Fred-Guo0422/Adapter-Functional-test-fixture/images/img2.jpg

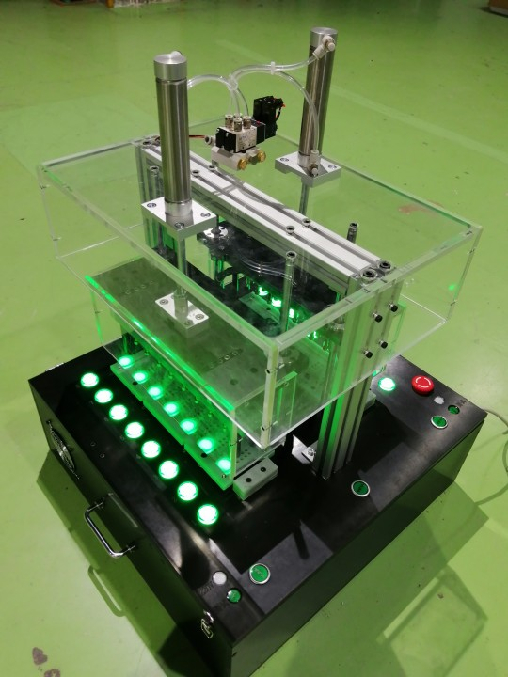
images/img2.jpg
