Fred-Guo0422/Adapter-Functional-test-fixture/images/img1.png

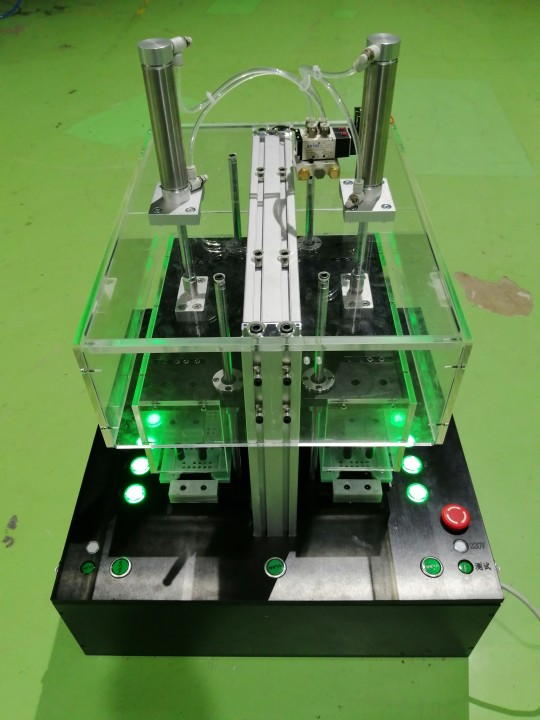
images/img1.png
