Fred-Guo0422/Adapter-Functional-test-fixture/README.md

#  Kambo Basic功能测试夹具

#### 介绍
赛尔康Kambo Basic功能测试夹具
输入图片说明

#### 软件架构
软件架构说明

#### 安装教程

#### 使用说明

#### 参与贡献

1.  Fork 本仓库
2.  新建 Feat_xxx 分支
3.  提交代码
4.  新建 Pull Request

#### 特技
