Fred-Guo0422/Adapter-Functional-test-fixture/TAE-22001JC Kambo Basic功能测试夹具 PO单9700009738.pdf

Payment terms | AMS 30 days | Currency RMB
Delivery terms | DDP Guigang

Mode of transport
We'd ask you to send the order confirmation within two working days
from the order date. PLS NOTE: Delivery time at destination. _______________________________________________________________________
Item | Our code | Your code | Storage Location
| Description
Delivery Date | Quantity Unit | Price _______________________________________________________________________

00010
Kambo Basic功能测试夹具 | Req.No: FR21121101
PR No./Item: 85781705/00010 | Requestor: Leon Gan
31.12.2021 | 1 SET | 13,570.00/1
13,570.00
Order 9M210034
_______________________________________________________________________ Tot. net item val. excl. tax RMB 13,570.00

苏州领略智能科技有限公司
苏州市相城区黄埭镇太东路2988号
苏州
Telefax:

Delivery address
Salcomp (Guigang) Co., Ltd.
China
Xijiang Industrial Park, Gangbei Di Guigang 537104

Delivery date Day 31.12.2021

_______________________________________________________________________

Company Name | Address | Telephone No. | Fax No.. | Bank account:
Salcomp | Salcomp Road, Xijiang industrial park | ,+86(755) 27255 111 | +86(755)27255 255 | Shenzhen PingAn Bank,
(Guigang) Co., Ltd. | Gangbei district, Guigang City | | +86(755)27255 677 | Shajing Branch
| Guangxi province - 537104, China | | | Swift Code: Guigang

____________________________________________________________________ MRO PO(GG)

PO number/date
9700009738 / 20.12.2021
Contact person/Telephone
HLI-Henry LI/755-27255111
Our fax number
+86-755-27255 255

Your vendor number with us
900170

_______________________________________________________________________

Item | Our code | Your code | Storage Location
| Description
Delivery Date | Quantity Unit | Price _______________________________________________________________________
Approved by | Made by
Tracy Hu | Henry LI
20.12.2021
_______________ | _______________

苏州领略智能科技有限公司
苏州市相城区黄埭镇太东路2988号
苏州

Environment Requirement: All the materials delivered to Salcomp should be compliance to the latest version requirement of <GWI 4-11 Salcomp Hazardous Substances Management Standard> _______________________________________________________________________

Company Name | Address | Telephone No. | Fax No.. | Bank account:
Salcomp | Salcomp Road, Xijiang industrial park | ,+86(755) 27255 111 | +86(755)27255 255 | Shenzhen PingAn Bank,
(Guigang) Co., Ltd. | Gangbei district, Guigang City | | +86(755)27255 677 | Shajing Branch
| Guangxi province - 537104, China | | | Swift Code: Guigang

____________________________________________________________________

PO number/date
9700009738 / 20.12.2021

Page
2 ( 2)
