Fred-Guo0422/Adapter-Functional-test-fixture/发包清单/TAE-22001JC Kambo Basic功能测试夹具发包明细1221V1.0.xls

Sheet: 发包申请单
 | 2021-12-21
苏州领略智能发包申请单
案名: | Kambo Basic功能测试夹具 |  |  |  | 案号: | TAE-22001JC |  |  | 本案第( 1 )次发包
序号 | 名称/规格 |  | 数量 | 预估金额 | 请购日期 | 需求日期 | 设计者 | 应用单位 | 建议厂商及备注事项
1 | 机构标准件明细表 |  | 1頁 |  | 2021-12-21 | 2021-12-29 | 曾凡超 | 贵港赛尔康
2 | 机构加工件明细表 |  | 1頁 |  | 2021-12-21 | 2021-12-29 | 曾凡超 | 贵港赛尔康
3 | 测试标准件明细表 |  | 1頁 |  | 2021-12-21 | 2021-12-29 | 李游 | 贵港赛尔康
4 | 以下空白
本次发包预算小计(RMB)元
预算管控 |  | 备品领用花费(RMB)元 |  |  | 预领备品确认 |  |  | 本次发包采购预算(RMB)元
执行单材料费： |  | 累计发包预算金额： |  |  |  |  | 剩余预算金额：
 |  | 累计实际预算金额： |  |  |  |  | 实际剩余金额：
备注 | 1﹑发包申请由设计者负责填写，要写清楚案名、案号、图号，发包前设计者在备品室确认预领备品，仓管员填写领用费用及签字后，交项目课长。
 | 2﹑本次发包预算小计及采购预算由项目课长依照备品领用费用核算后填写。
 | 3﹑发包申请由项目课长及总监审核后，核准生效。
 | 4﹑核准生效后，发包单同图纸及明细一并送工程管理处存档。
 | □ 新发包 | □ 客户设变 |  | □ 设计设变 |  | □ 其他设变 / |  | □ 加工件 | □ 标准件
核准﹕ |  |  | 企划： |  |  | 审核﹕ |  |  | 申请﹕

Sheet: 机构标准件明细表
苏州领略智能
标准件明细表
案 名 |  |  | Kambo Basic功能测试夹具 |  | 案 号 |  | TAE-22001JC
工 序 |  |  |  |  | 图 号 |  | TAE-22001JC
使用厂区及部门 |  |  |  |  | 产品名称
序号 | 物料编号 | 名 称 | 型 号 / 规 格 | 单位 | 单台数量 | 机台数 | 总数量 | 品牌
1 | 402-C-GKS100306150A3000E | 上顶探针 | GKS-100306150A3000E | pcs | 300 | 1 | 300 | INGUN | 1.2000035 | 360.00105
2 | 402-C-KS10047 | 上顶探针针套 | KS-100 47G | pcs | 300 | 1 | 300 | INGUN | 0.7000011 | 210.00033
3 | 402-C-MA32X100SU | 气缸 | MA32X100SU | PCS | 2 | 1 | 2 | 亚德客 | 74.2999973 | 148.5999946
4 | 402-C-4V11006B | 电磁阀 | 4V11006B | PCS | 2 | 1 | 2 | 亚德客 | 34.000005 | 68.00001
5 | 402-C-100M2F | 电磁阀底座 | 100M2F | PCS | 1 | 1 | 1 | 亚德客 | 13.6999957 | 13.6999957
6 | 402-C-LMG01D12 | 直线轴承(带法兰型) | LMG01-d12 | PCS | 4 | 1 | 4 | 怡合达 | 42.2299984 | 168.9199936
7 | 402-C-LMD01D8 | 直线轴承 | LMD01-d8 | PCS | 8 | 1 | 8 | 怡合达 | 18.6699956 | 149.3599648
8 | 402-C-YVUFD16L40 | 压缩弹簧 | YVUF-D16-L40 | PCS | 8 | 1 | 8 | 怡合达 | 11.6799964 | 93.4399712
9 | 402-C-L70X05 | 压缩弹簧 | 内径7 线径0.5 | 1米 | 2 | 1 | 2 | 国产 | 10.0000028 | 20.0000056
10 | 402-C-L68X06 | 压缩弹簧 | 内径6.8 线径0.6 | 1米 | 2 | 1 | 2 | 国产 | 10.0000028 | 20.0000056
11 | 402-C-FHL62B100100 | 氮气弹簧 | FHL62-B-100-100 | PCS | 4 | 1 | 4 | 怡合达 | 76.759996 | 307.039984
12 | 402-C-AOB053060L428LMRM | 欧标30系列铝型材 | AOB05-3060-L428-LM-RM | PCS | 3 | 1 | 3 | 怡合达 | 29.9499946 | 89.8499838
13 | 402-C-ABC01G3063050 | 铝型材配件 | ABC01-G306-30-50 | PCS | 4 | 1 | 4 | 怡合达 | 5.5799965 | 22.319986
14 | 402-C-AHQ22308M6 | 铝型材配件 | AHQ22-308-M6 | PCS | 20 | 1 | 20 | 怡合达 | 0.6199971 | 12.399942
15 | 402-C-HFV0240 | 合页 | HFV02-40 | PCS | 4 | 1 | 4 | 怡合达 | 8.4799946 | 33.9199784
16 | 402-C-HFQ0122 | 卡扣 | HFQ01-22 | PCS | 2 | 1 | 2 | 怡合达 | 6.7900005 | 13.580001
17 | 402-C-XAE61L100 | 把手 | XAE61-L100 | PCS | 2 | 1 | 2 | 怡合达 | 9.8000041 | 19.6000082
18 | 402-C-HAV61M8L16 | 把手 | HAV61-M8-L16 | PCS | 4 | 1 | 4 | 怡合达 | 8.1900027 | 32.7600108
19 | 402-C-FTTT | 铜套 | 附图（铜套） | pcs | 100 | 1 | 100 |  | #N/A | #N/A
 |  |  | 以下空白
10
11
12
13
14
15
1
2
3
4
5
6
7
8
9
10
11
12
1
2
3
4
5
6
7
8
9
10
11
 |  |  | 、 |  |  | 、

Sheet: 机构加工件明细表
苏州领略智能
加工件明细表
案 名 |  |  | Kambo Basic功能测试夹具 |  |  | 案 号 |  | TAE-22001JC
工 序 |  |  |  |  |  | 图 号 |  | TAE-22001JC
使用厂区及部门 |  |  |  |  |  | 产品名称
序号 | 物料编码 | 名 称 | 型 号 / 规 格 | 单位 | 单台数量 | 机台数 | 总数量 | 品牌 | 备 注
1 | 501-0122001JC00101-01 |  | TAE-22001JC-001-01 | PCS | 1 | 1 | 1
2 |  |  | TAE-22001JC-001-02 | PCS | 1 | 1 | 1
3 |  |  | TAE-22001JC-001-03 | PCS | 1 | 1 | 1
4 |  |  | TAE-22001JC-001-04 | PCS | 1 | 1 | 1
5 |  |  | TAE-22001JC-001-05 | PCS | 1 | 1 | 1
6 |  |  | TAE-22001JC-001-06 | PCS | 1 | 1 | 1
7 |  |  | TAE-22001JC-001-07 | PCS | 1 | 1 | 1
8 |  |  | TAE-22001JC-001-08 | PCS | 4 | 1 | 4
9 |  |  | TAE-22001JC-001-09 | PCS | 4 | 1 | 4
10 |  |  | TAE-22001JC-001-10 | PCS | 2 | 1 | 2
11 |  |  | TAE-22001JC-001-11 | PCS | 2 | 1 | 2
12 |  |  | TAE-22001JC-001-12 | PCS | 2 | 1 | 2
13 |  |  | TAE-22001JC-001-13 | PCS | 2 | 1 | 2
14 |  |  | TAE-22001JC-001-14 | PCS | 2 | 1 | 2
15 |  |  | TAE-22001JC-001-15 | PCS | 2 | 1 | 2
16 |  |  | TAE-22001JC-001-16 | PCS | 2 | 1 | 2
17 |  |  | TAE-22001JC-001-17 | PCS | 4 | 1 | 4
18 |  |  | TAE-22001JC-001-18 | PCS | 2 | 1 | 2
19 |  |  | TAE-22001JC-001-19 | PCS | 2 | 1 | 2
20 |  |  | TAE-22001JC-001-23 | PCS | 2 | 1 | 2
21 |  |  | TAE-22001JC-001-24 | PCS | 2 | 1 | 2
22 |  |  | TAE-22001JC-001-25 | PCS | 8 | 1 | 8
23 |  |  | TAE-22001JC-001-26 | PCS | 2 | 1 | 2
24 |  |  | TAE-22001JC-001-27 | PCS | 8 | 1 | 8
25 |  |  | TAE-22001JC-001-28 | PCS | 2 | 1 | 2
26 |  |  | TAE-22001JC-001-29 | PCS | 6 | 1 | 6
27 |  |  | TAE-22001JC-001-30 | PCS | 6 | 1 | 6
28 |  |  | TAE-22001JC-001-31 | PCS | 20 | 1 | 20
29 |  |  | TAE-22001JC-001-32 | PCS | 2 | 1 | 2
30 |  |  | TAE-22001JC-001-33 | PCS | 2 | 1 | 2
31 |  |  | TAE-22001JC-001-41 | PCS | 4 | 1 | 4
32 |  |  | TAE-22001JC-001-42 | PCS | 8 | 1 | 8
33 |  |  | TAE-22001JC-001-43 | PCS | 8 | 1 | 8
 |  |  | 以下空白

Sheet: 测试标准件
苏州领略智能研发部
标准件明细表
案 名 |  |  | Kambo Basic功能测试夹具 |  | 案 号 |  | TAE-22001JC
工 序 |  |  |  |  | 图 号 |  | TAE-22001JC
使用厂区及部门 |  |  |  |  | 产品名称
序号 | 物料编号 | 名 称 | 型 号 / 规 格 | 单位 | 单台数量 | 机台数 | 总数量 | 品牌 | 备注
1 | 402-A-DVP14SS211R | PLC | DVP-14SS211R | PCS | 1 | 1 | 1 | 台达 |  | 457.9999949 | 457.9999949
2 | 402-A-DVP08SN11R | PLC扩展模块 | DVP-08SN11R | PCS | 4 | 1 | 4 | 台达 |  | 239.9999994 | 959.9999976
3 | 402-A-MY2NJ24VDC | 中间继电器 | MY2NJ-24VDC | PCS | 20 | 1 | 20 | 欧姆龙 |  | 13.9999994 | 279.999988
4 | 402-A-PYFZ08E | 继电器座 | PYFZ-08-E | PCS | 20 | 1 | 20 | 欧姆龙 |  | 10.0000028 | 200.000056
5 | 402-A-HF024M | 24pin重载连接器插芯-HF芯体系列 | HF-024-M | PCS | 1 | 1 | 1 | 唯恩 |  | 74.0000049 | 74.0000049
6 | 402-A-HDD108MC | HDD-108-MC重载连接器插芯-HDD芯体系列 | HDD-108-MC | PCS | 1 | 1 | 1 | 唯恩 |  | 100.0000054 | 100.0000054
7 | 402-A-H24BMBK2LSC | 重载连接器外壳 | H24B-MBK-2L/SC | PCS | 2 | 1 | 2 | 唯恩 |  | 180.0000052 | 360.0000104
8 | 402-A-CDSM15 | 冷压针 | CDSM-2.5 10A | PCS | 100 | 1 | 100 | 唯恩 |  | 2.5999944 | 259.99944
9 | 402-A-YJ139LA38A11DN | 启动开关 | YJ139-LA38A-11DN△○ | PCS | 3 | 1 | 3 | 一佳 |  | 10.0000028 | 30.0000084
10 | 402-A-YJ139LA38A11ZS | 急停钮（推锁旋放式） | YJ139-LA38A-11ZS（红色） | PCS | 2 | 1 | 2 | 一佳 |  | 12.9999946 | 25.9999892
11 | 402-A-AD1622SS | Φ22双色灯 | AD16-22SS | PCS | 18 | 1 | 18 | 一佳 |  | 8.999998 | 161.999964
12 | 402-A-AD1616ERDC24V | Φ16信号灯（红色24V） | AD16-16E-R-DC24V | PCS | 2 | 1 | 2 | 一佳 |  | 8.999998 | 17.999996
13 | 402-A-AD1616EGDC24V | Φ16信号灯（绿色24V） | AD16-16E-G-DC24V | PCS | 2 | 1 | 2 | 一佳 |  | 5.9999949 | 11.9999898
14 | 402-A-FG90 | SNOWFAN 塑胶单片网 | 塑胶单片网FG-90 | PCS | 1 | 1 | 1 | SNOWFAN |  | 1.9999983 | 1.9999983
15 | 402-A-ST90 | 金属防护铁丝网 | ST-90 | PCS | 1 | 1 | 1 | SNOWFAN |  | 1.6000009 | 1.6000009
16 | 402-A-YY9225H24B24V002A | 散热风扇 | YY9225H24B 24V 0.02A | PCS | 1 | 1 | 1 | SNOWFAN |  | 22.9999974 | 22.9999974
17 | 402-A-APCJ1011FR03 | AC电源开关插座 | APCJ-101-1FR-03 | PCS | 2 | 1 | 2 | 米思米 |  | 10.0000028 | 20.0000056
18 | 402-A-LJ12A32ZBXDC24V | 电感式接近开关(NPN) | LJ12A3-2-Z/BX（DC24V） | PCS | 2 | 1 | 2 | OMCH | https://detail.tmall.com/item.htm?id=574636197291&cm_id=140105335569ed55e27b&abbucket=17&skuId=4529057856425 | 12.0000011 | 24.0000022
19 | 402-A-5ADC | 电源模块24v/12V转5V | 5A降压DC直流电源模块 | PCS | 2 | 1 | 2 | Risym | https://detail.tmall.com/item.htm?id=543121704361&ns=1&abbucket=17&skuId=4102784361873 | 24.0000022 | 48.0000044
20 | 402-A-RV1255R | 圆形绝缘端子 | RV1.25-5（红色1000个） | 包 | 1 | 1 | 1 | ZYCN/宗意 |  | 45.9999948 | 45.9999948
21 | 402-A-RV1255B | 圆形绝缘端子 | RV1.25-5（蓝色1000个） | 包 | 1 | 1 | 1 | ZYCN/宗意 | https://detail.tmall.com/item.htm?id=615107608761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 | 45.9999948 | 45.9999948
以下空白 |  |  |  |  |  |  |  |  |  |  | 3150.599443
10
11
12
13
14
15
1
2
3
4
5
6
7
8
9
10
11
12
1
2
3
4
5
6
7
8
9
10
11 |  |  |  |  |  | 、
 |  |  | 、
