Fred-Guo0422/Adapter-Functional-test-fixture/Kambo Basic ATE 报价单.xlsx

 | Quotation 报价单
To: | 李宏焕 | Tel: | -18507852673 | From: | 李新玉 | Tel: | 13055136226
Email: |  |  |  | Email: | li.xin.yu/李新玉5027786 <li.xin.yu@lingyiitech.com>
Attn: | (客户公司)赛尔康（贵港）有限公司 |  |  | Attn: | 苏州领略智能科技有限公司
Add: | (客户公司)赛尔康（贵港）有限公司 |  |  | Add: | 苏州领略智能科技有限公司
案名 |  | 小米LED测试夹具 |  |  | 案号
需求单位 |  | 赛尔康（贵港）有限公司 |  |  | 承制单位 | 东莞自动化
项目性质 |  | □设备研发 □设备改善(原案号 ) ■其它 ( )
需求说明
序号 | 项目类别 | 名称 | 品牌 | 型号 |  |  | 数量 | 备注
1 | 小米LED测试夹具 | 小米LED测试夹具 | 华东自动化 | 自制非标设备 |  |  | 1
 |  |  |  |  | 材料成本 |  | 11800.00 | 未税材料价格
 |  |  |  |  | 人工费 |  | 2360.00 | 20%
 |  |  |  |  | 管理费 |  | 1180.00 | 10%
 |  |  |  |  | 利润 |  | 590.00 | 5%
 |  |  |  |  | 未税单价 |  | 13570.00
 |  |  |  |  | 未税总价 |  | 13570.00
 |  |  |  |  | 含税单价 |  | 15334.10 | 13%
 |  |  |  |  | 含税总价 |  | 15334.10
客户回签:
核准: |  |  | 审核: |  |  | 承办:
核准: |  |  | 审核: |  |  | 承办:
备注:
1, | 此金额为人民币报价
2, | 运费说明,以上报价含陆运运费
3, | 交期说明,根据对方订单要求 |  |  |  |  |  |  |  | 待启动
4, | 付款条件,财务划款
5, | 付款要求,只接受支票、电汇、转账、不收期票和银行承兑汇票
6, | 报价有效期限,此报价单有效期为报价日期起一周内
