Fred-Guo0422/Adapter-Functional-test-fixture/结构 2D+3D/TAE-22001JC-001-05.STEP

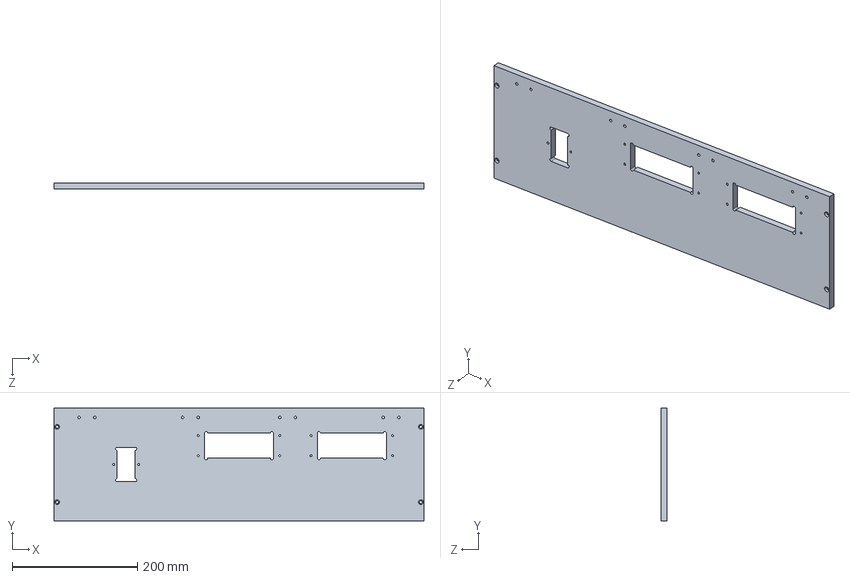
[picture p3: CAD file, 2022-05-23]
结构 2D+3D/TAE-22001JC-001-05.STEP
590.0 x 180.0 x 10.0 mm
