Fred-Guo0422/Adapter-Functional-test-fixture/结构 2D+3D/TAE-22001JC-001-19.STEP

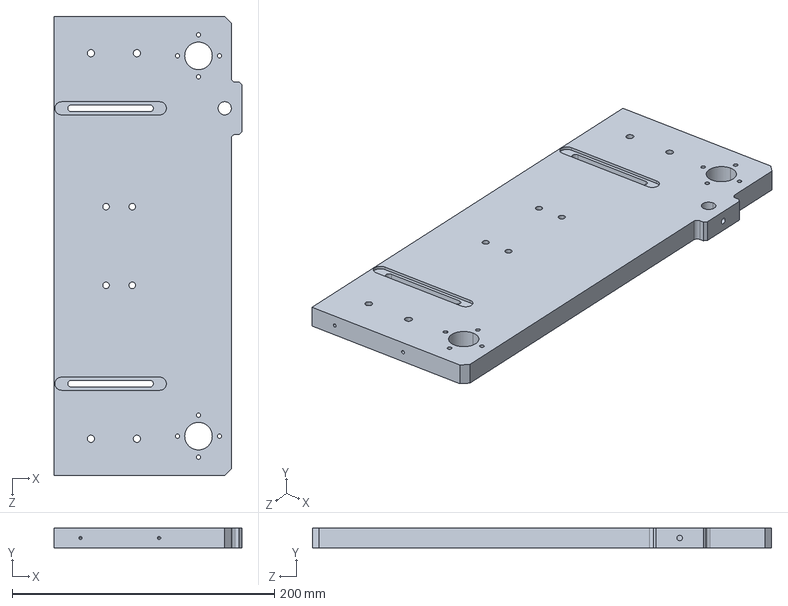
[picture p4: CAD file, 2022-05-23]
结构 2D+3D/TAE-22001JC-001-19.STEP
143.0 x 15.0 x 350.0 mm
