Fred-Guo0422/Adapter-Functional-test-fixture/结构 2D+3D/TAE-22001JC-001-06.STEP

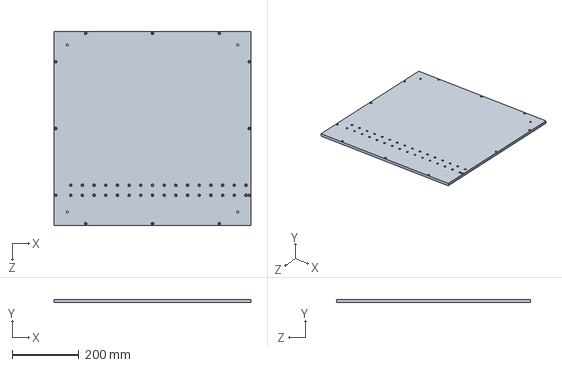
[picture p6: CAD file, 2022-05-23]
结构 2D+3D/TAE-22001JC-001-06.STEP
590.0 x 10.0 x 580.0 mm
