Fred-Guo0422/Adapter-Functional-test-fixture/结构 2D+3D/TAE-22001JC-001-28.STEP

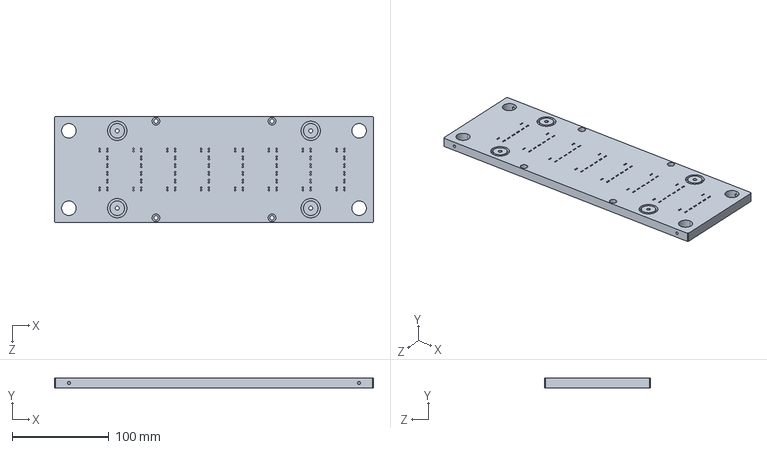
[picture p7: CAD file, 2022-05-23]
结构 2D+3D/TAE-22001JC-001-28.STEP
329.7 x 10.0 x 109.7 mm
