Fred-Guo0422/Adapter-Functional-test-fixture/结构 2D+3D/TAE-22001JC-001-07.STEP

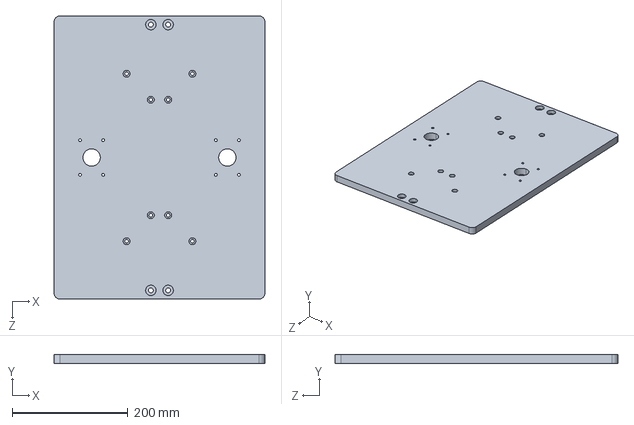
[picture p9: CAD file, 2022-05-23]
结构 2D+3D/TAE-22001JC-001-07.STEP
365.0 x 15.0 x 490.0 mm
