Fred-Guo0422/Adapter-Functional-test-fixture/结构 2D+3D/TAE-22001JC-001-41.STEP

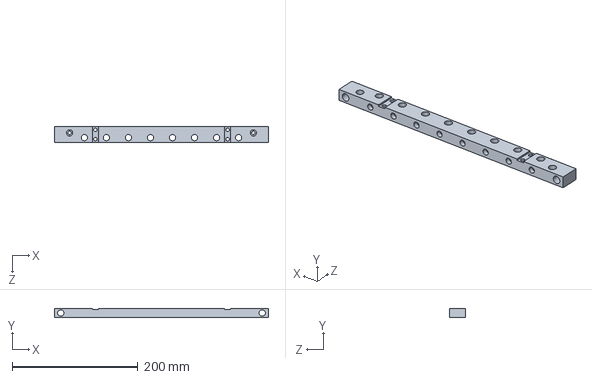
[picture p11: CAD file, 2022-05-23]
结构 2D+3D/TAE-22001JC-001-41.STEP
340.0 x 15.0 x 25.0 mm
