Fred-Guo0422/Adapter-Functional-test-fixture/结构 2D+3D/TAE-22001JC-001-26.STEP

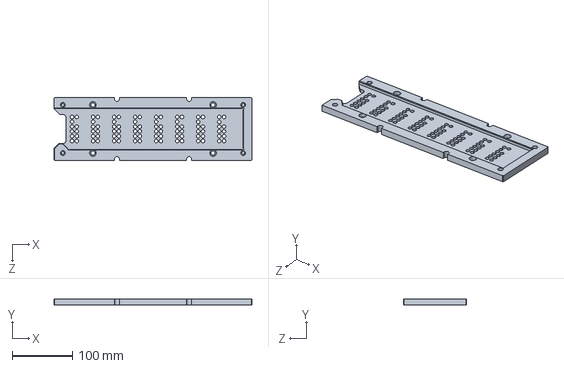
[picture p12: CAD file, 2022-05-23]
结构 2D+3D/TAE-22001JC-001-26.STEP
329.5 x 10.0 x 105.0 mm
