Fred-Guo0422/Adapter-Functional-test-fixture/(list of files, cad)

Other CAD files:
结构 2D+3D/TAE-22001JC-001-10.dwg
结构 2D+3D/铜套.dwg
结构 2D+3D/TAE-22001JC-001-09.dwg
结构 2D+3D/TAE-22001JC-001-43.DWG
结构 2D+3D/TAE-22001JC-001-11.dwg
结构 2D+3D/TAE-22001JC-001-33.dwg
结构 2D+3D/TAE-22001JC-001-14.dwg
结构 2D+3D/TAE-22001JC-001-23.dwg
结构 2D+3D/TAE-22001JC-001-08.dwg
结构 2D+3D/TAE-22001JC-001-16.dwg
结构 2D+3D/TAE-22001JC-001-15.dwg
结构 2D+3D/TAE-22001JC-001-01.dwg
结构 2D+3D/TAE-22001JC-001-12.dwg
结构 2D+3D/TAE-22001JC-001-25.dwg
结构 2D+3D/TAE-22001JC-001-29.dwg
结构 2D+3D/TAE-22001JC-001-13.dwg
结构 2D+3D/TAE-22001JC-001-24.dwg
结构 2D+3D/TAE-22001JC-001-31.dwg
结构 2D+3D/TAE-22001JC-001-32.dwg
结构 2D+3D/TAE-22001JC-001-42.dwg
结构 2D+3D/TAE-22001JC-001-18.dwg
结构 2D+3D/TAE-22001JC-001-17.dwg
结构 2D+3D/TAE-22001JC-001-27.dwg
结构 2D+3D/TAE-22001JC-001-02.dwg
结构 2D+3D/TAE-22001JC-001-03.dwg
结构 2D+3D/TAE-22001JC-001-04.dwg
结构 2D+3D/TAE-22001JC-001-05.dwg
结构 2D+3D/TAE-22001JC-001-06.dwg
结构 2D+3D/TAE-22001JC-001-07.dwg
结构 2D+3D/TAE-22001JC-001-19.dwg
结构 2D+3D/TAE-22001JC-001-26.dwg
结构 2D+3D/TAE-22001JC-001-28.dwg
结构 2D+3D/TAE-22001JC-001-30.dwg
结构 2D+3D/TAE-22001JC-001-41.dwg
