Fred-Guo0422/Adapter-Functional-test-fixture/结构 2D+3D/TAE-22001JC-001-23.pdf

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

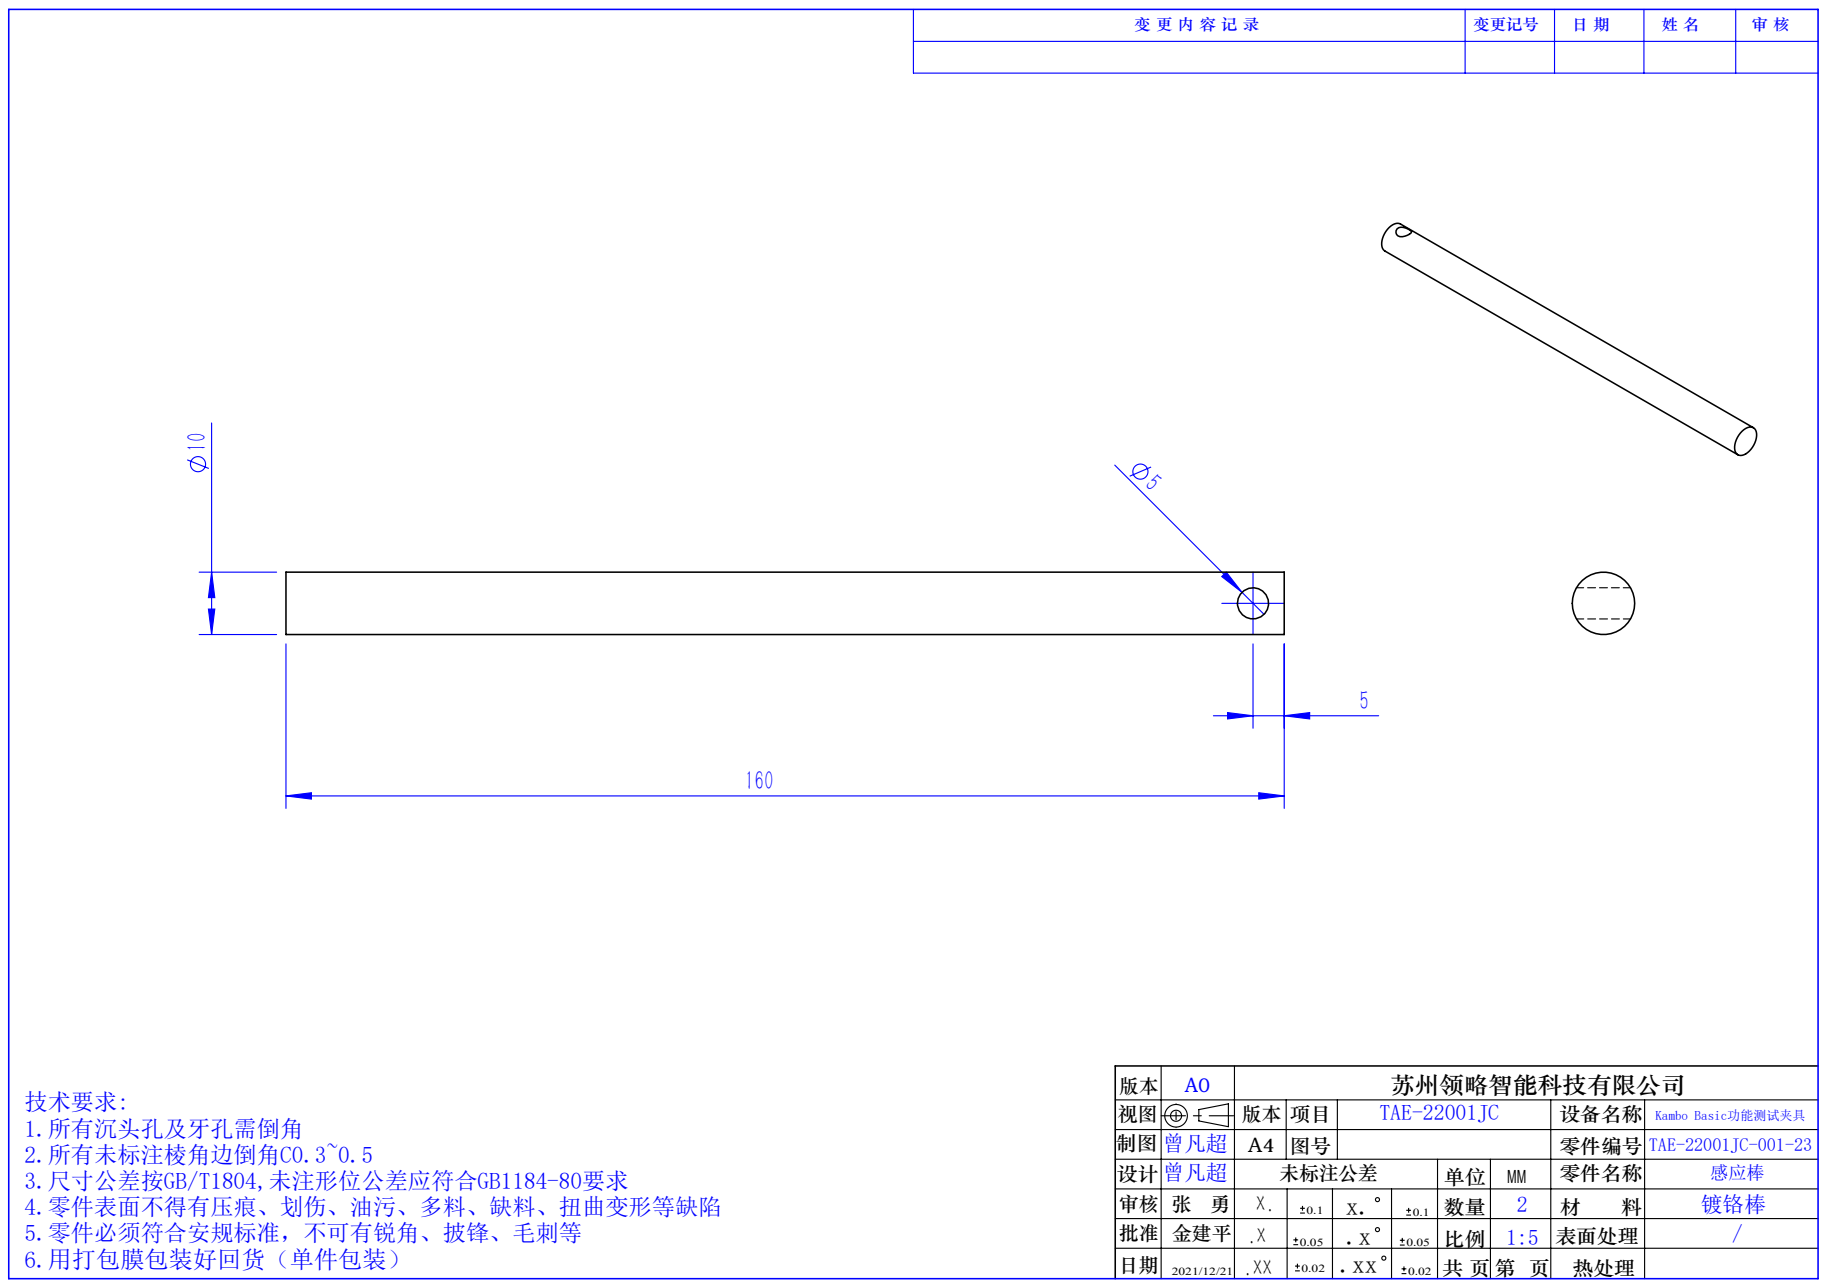
[picture p32: page 1]
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
