Fred-Guo0422/Adapter-Functional-test-fixture/结构 2D+3D/TAE-22001JC-001-32.pdf

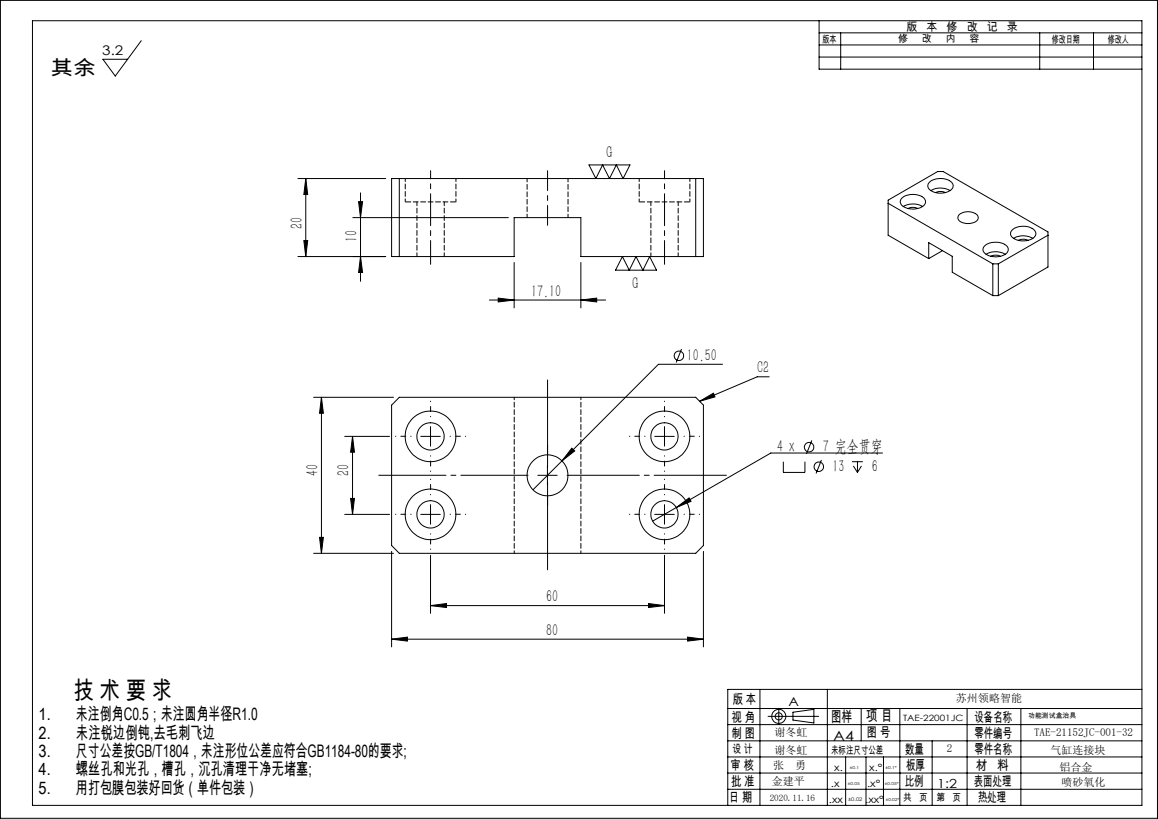
[picture p41: page 1]
7 完全贯穿; 5. 用打包膜包装好回货（单件包装）; 4. 螺丝孔和光孔，槽孔，沉孔清理干净无堵塞;; 3. 尺寸公差按GB/T1804，未注形位公差应符合GB1184-80的要求;; 2. 未注锐边倒钝,去毛刺飞边; 1. 未注倒角C0.5；未注圆角半径R1.0; 设备名称; 修改日期; 修改人
