Fred-Guo0422/Adapter-Functional-test-fixture/结构 2D+3D/铜套.pdf

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

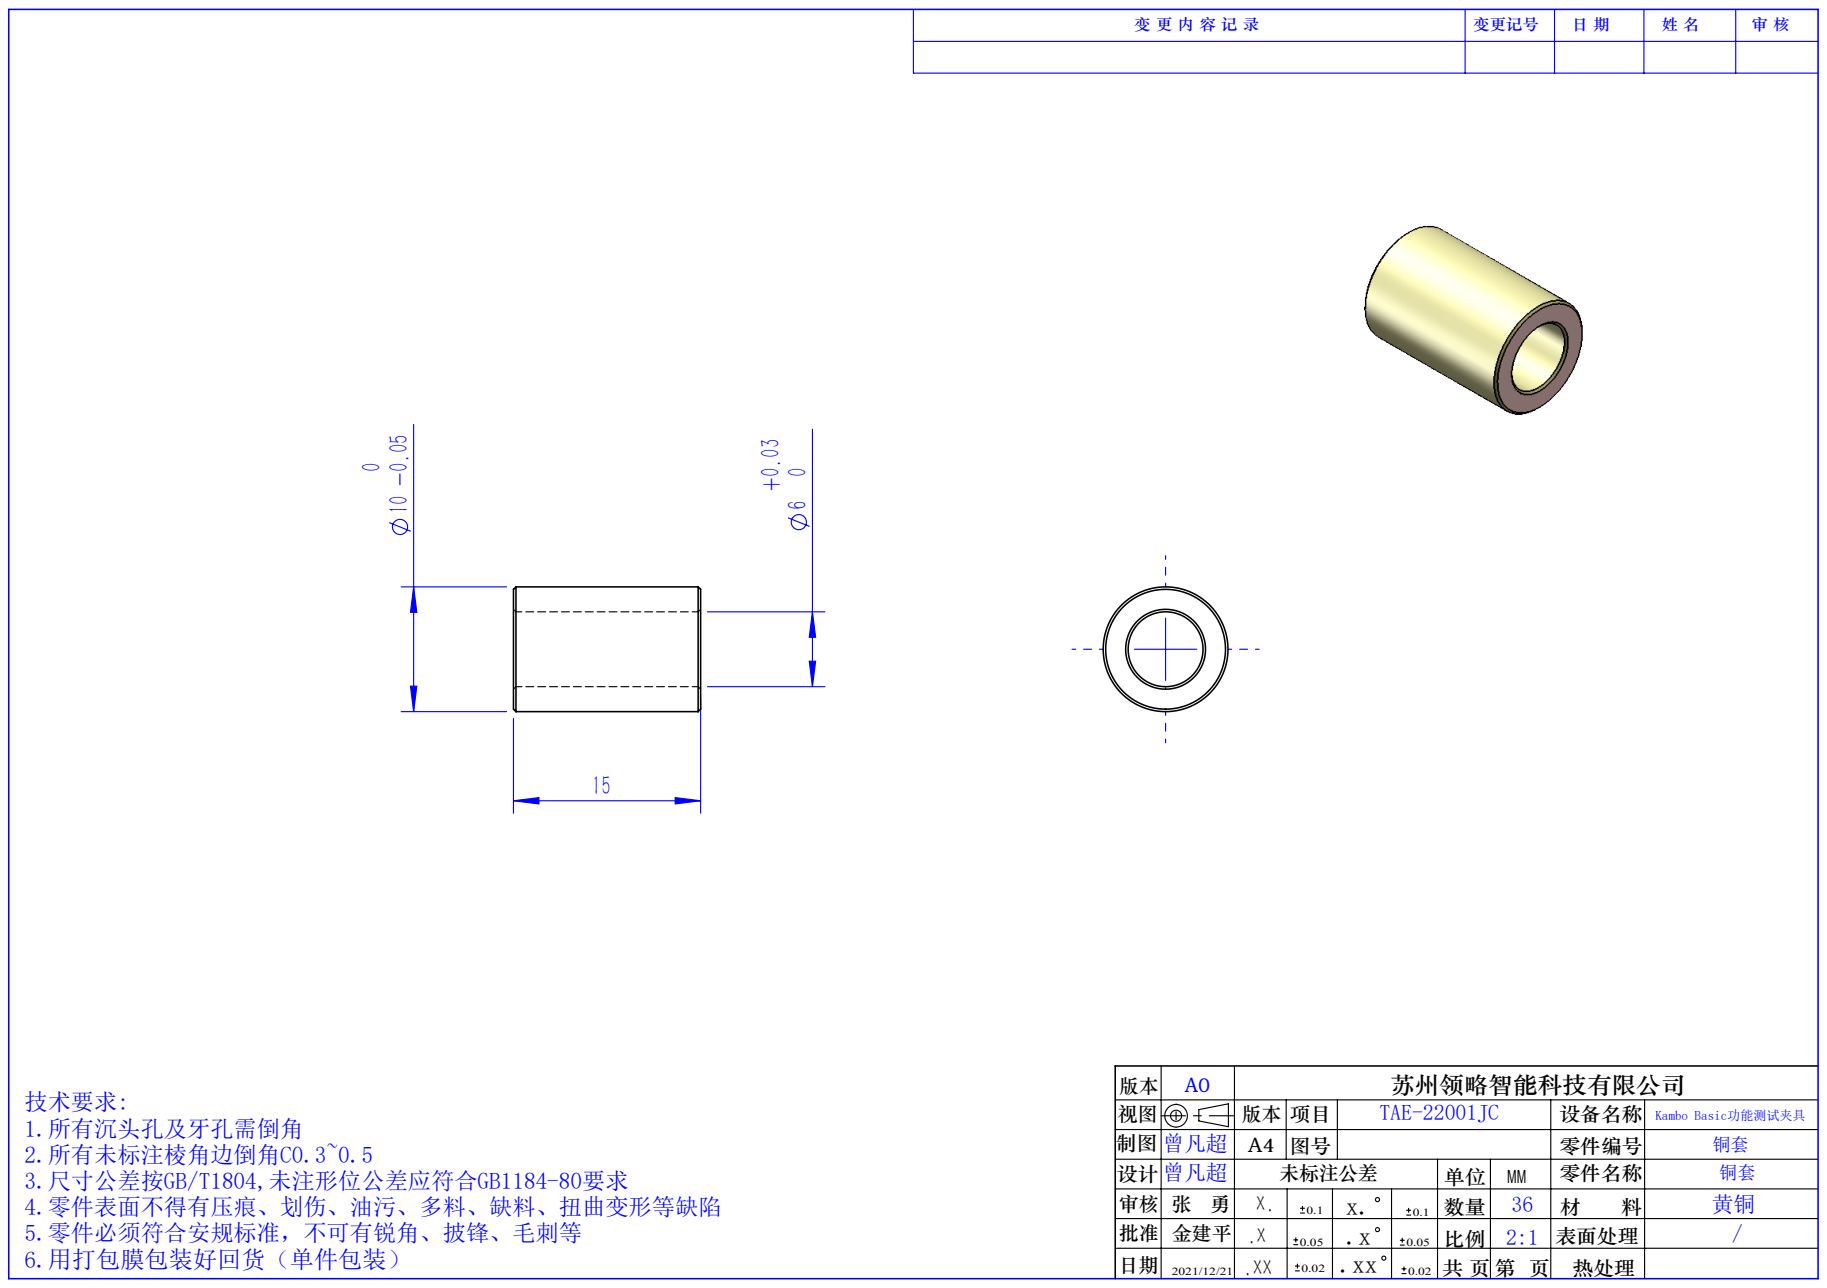
[picture p46: page 1]
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
